c0de111/tinta/hardware/circuit/tinta_l2.pdf

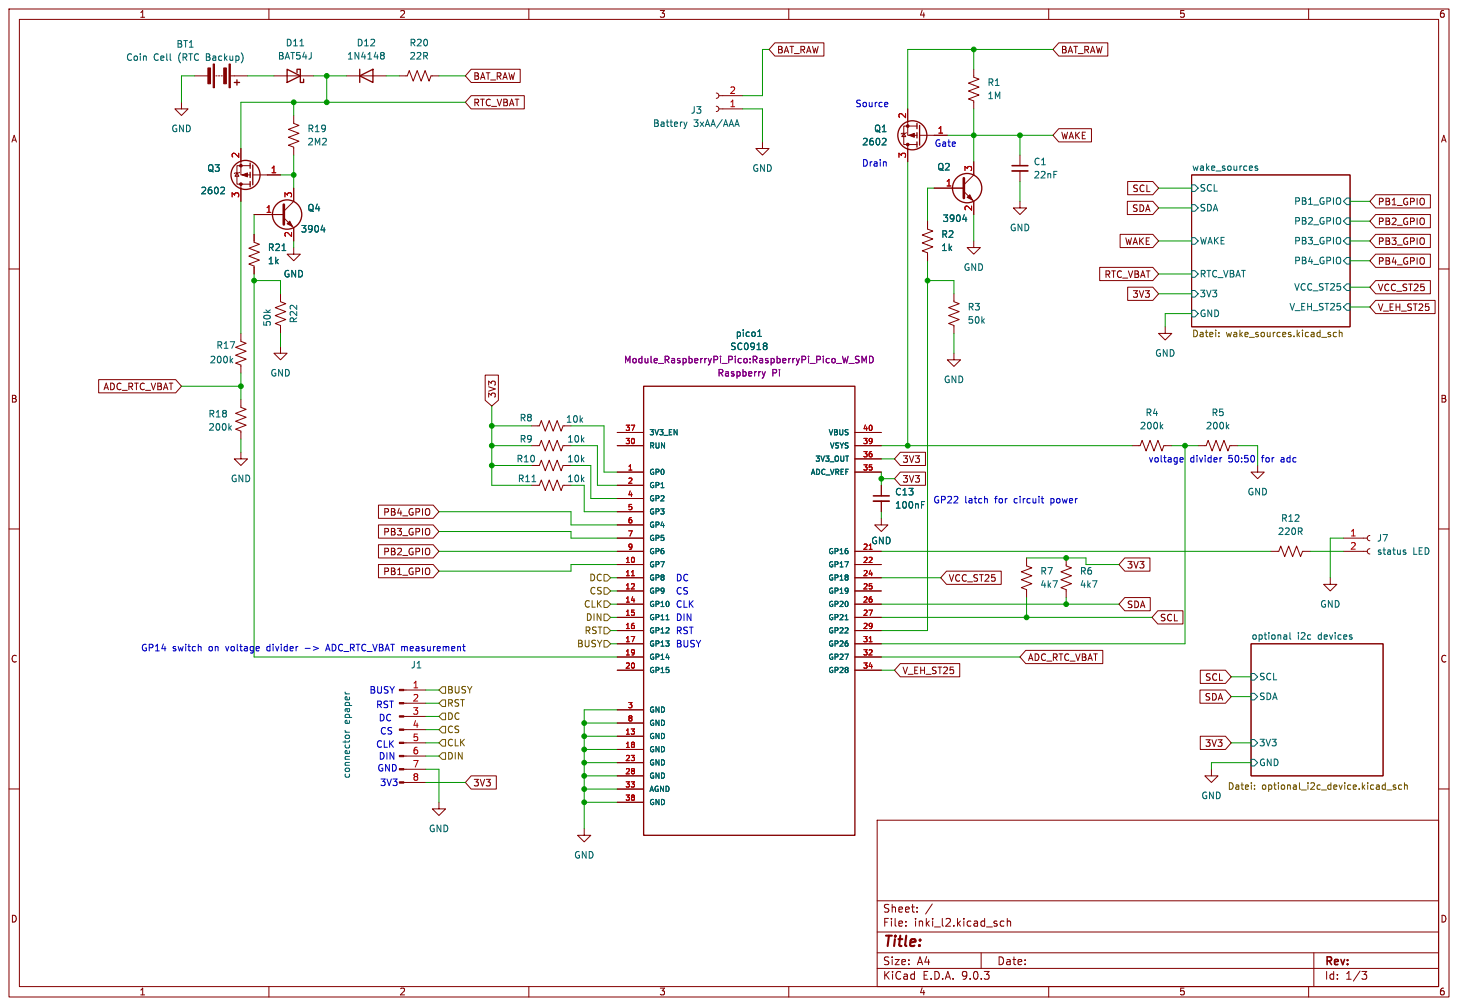
[picture p3: page 1]

BUSY RST CS DC

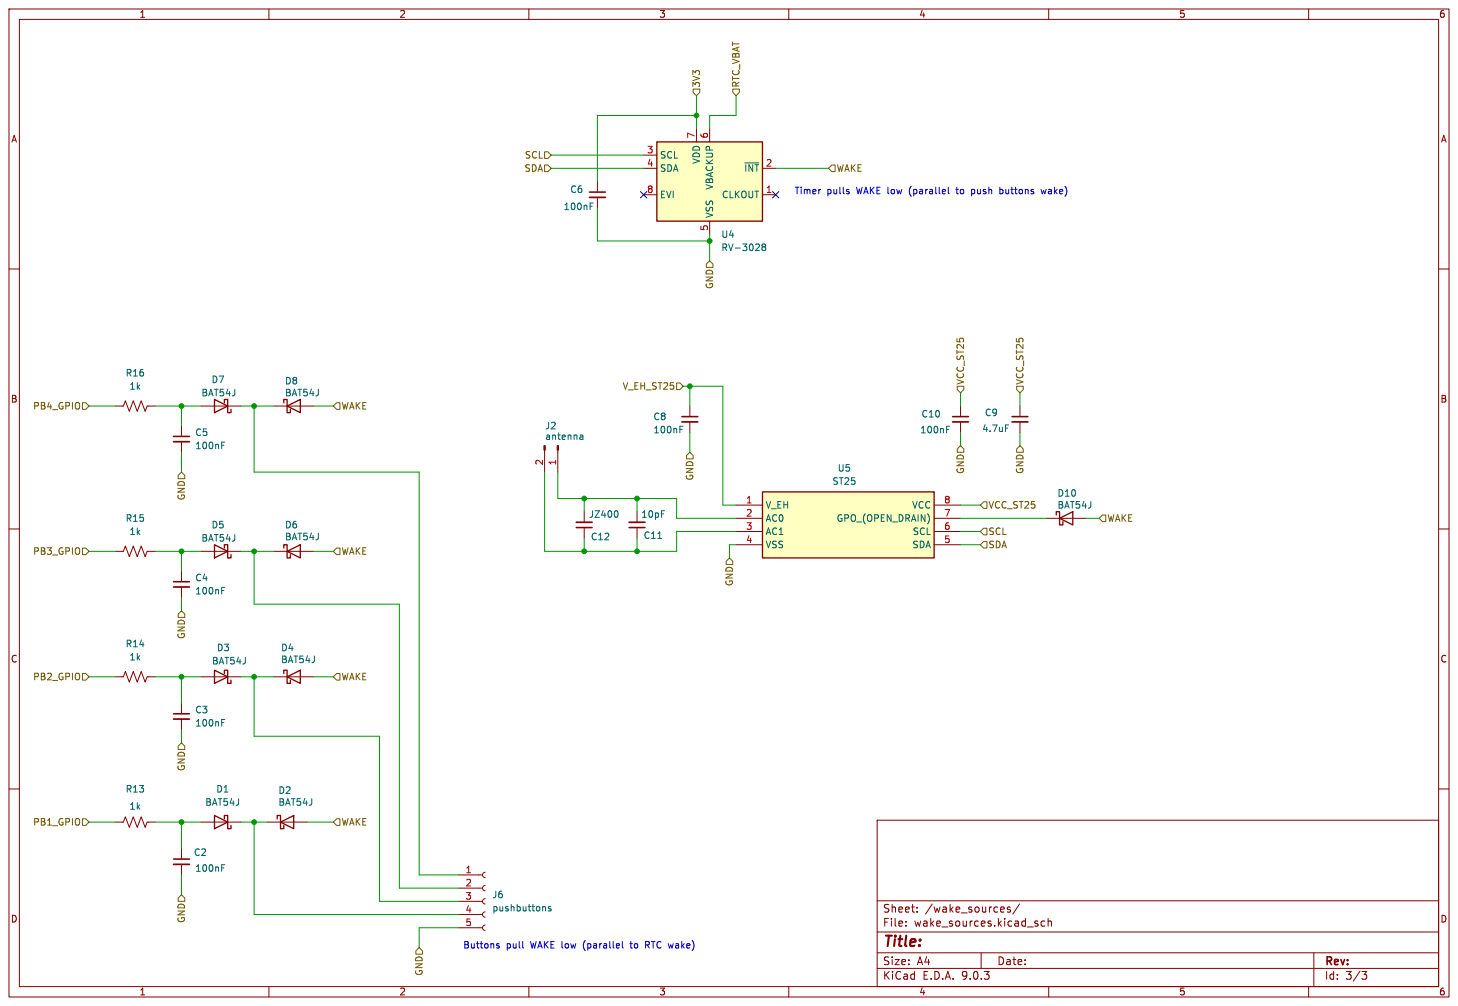
[picture p4: page 2]

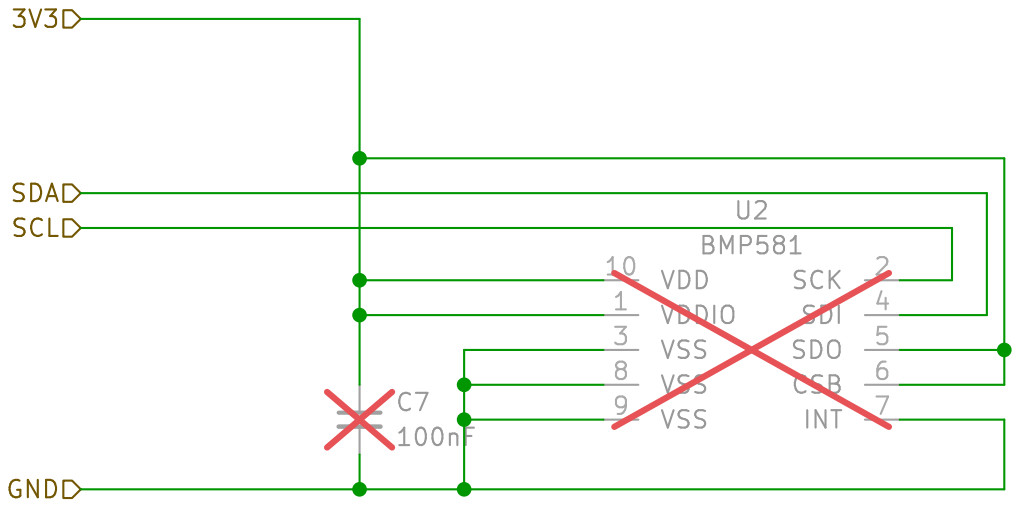
[picture p5: page 3]
