c0de111/tinta/hardware/circuit/tinta_l2.kicad_pcb

## KiCad design hardware/circuit/tinta_l2.kicad_pcb (2026-10-27)

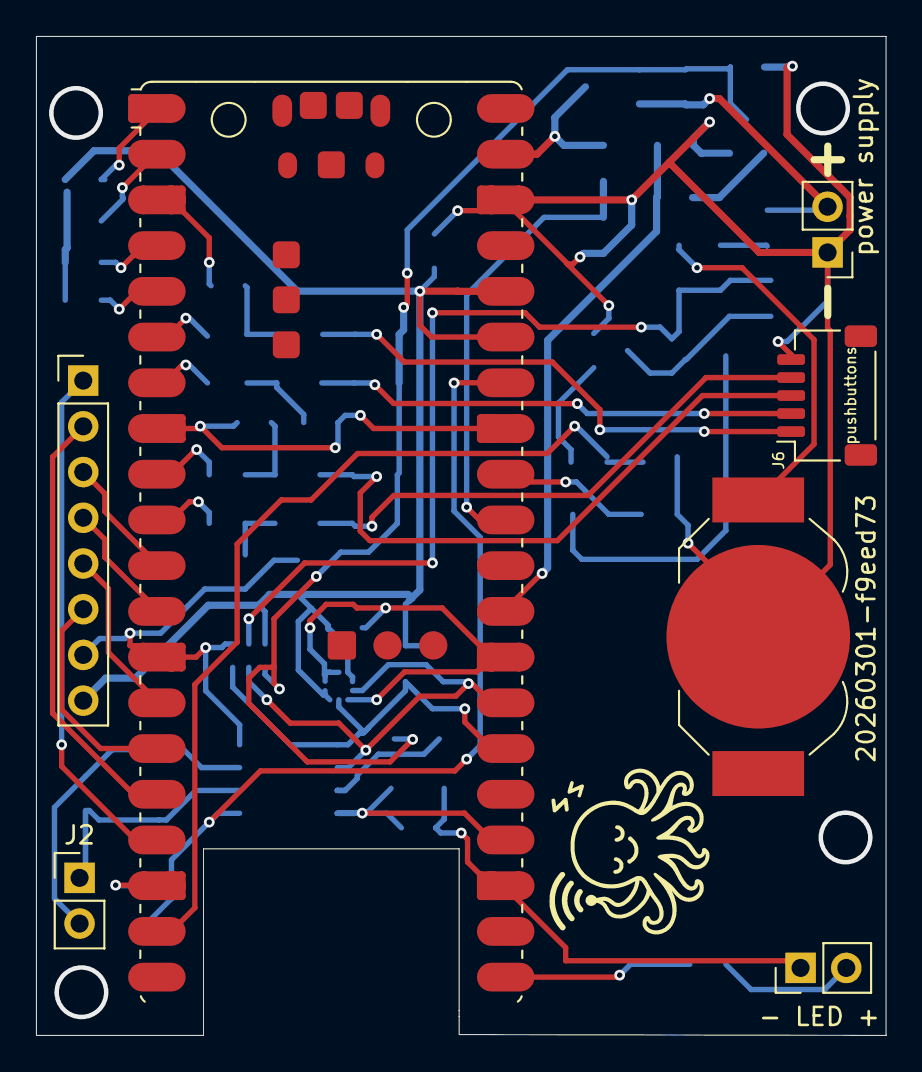
[picture p6: board tinta_l2.kicad_pcb from above]

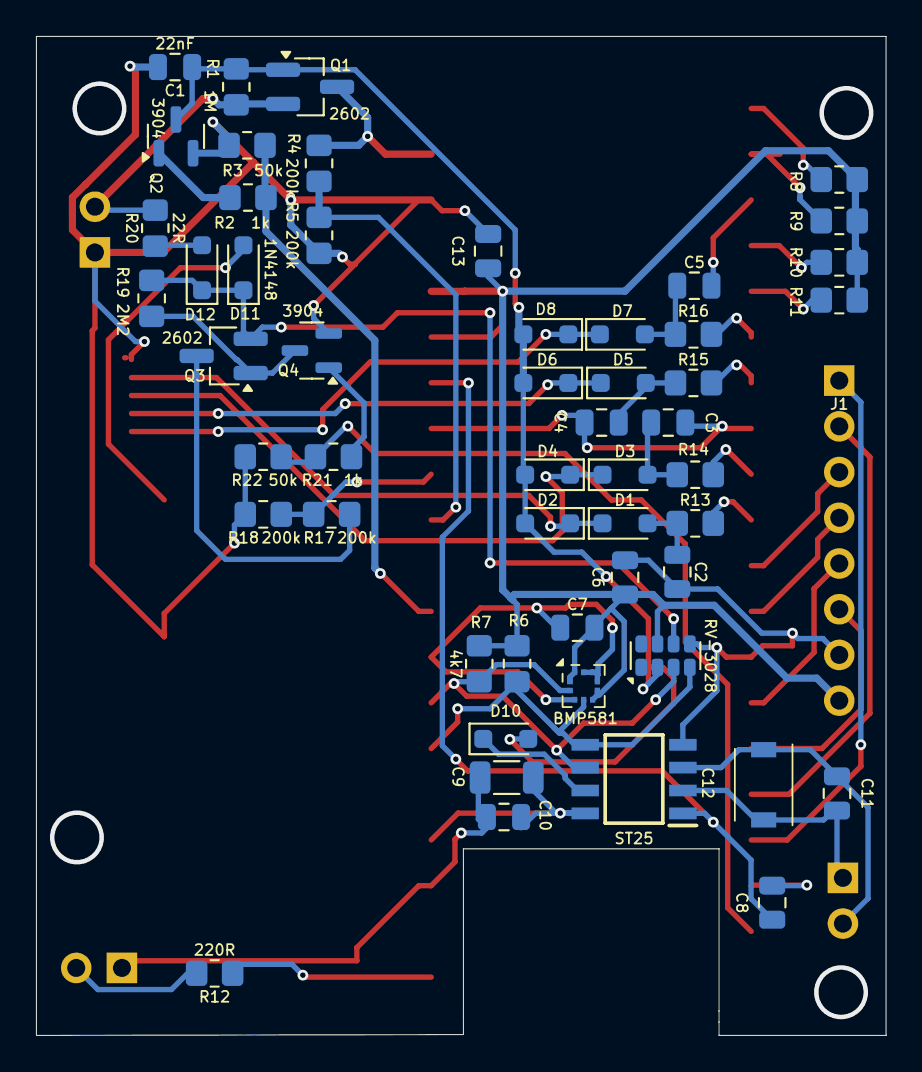
[picture p7: board tinta_l2.kicad_pcb from below]

Board: 2 copper layers, 47.2 x 55.5 mm, 60 parts (53 on the bottom side), 47 nets.

Parts:
BT1: Coin Cell (RTC Backup); BatteryHolder_LINX_BAT-HLD-012-SMT
C1: 22nF; C_0805_2012Metric
C2, C3, C4, C5, C6, C7, C8, C10, C13: 100nF; C_0805_2012Metric
C9: 4.7uF; C_1206_3216Metric
C11: 10pF; C_0805_2012Metric
C12: JZ400
D1, D2, D3, D4, D5, D6, D7, D8, D10, D11: BAT54J; D_SOD-323_HandSoldering
D12: 1N4148; D_SOD-323_HandSoldering
J1: connector epaper; PinHeader_1x08_P2.54mm_Vertical
J2: antenna; PinHeader_1x02_P2.54mm_Vertical
J3: Battery 3xAA/AAA; PinHeader_1x02_P2.54mm_Vertical
J6: pushbuttons; JST_SH_SM05B-SRSS-TB_1x05-1MP_P1.00mm_Horizontal
J7: status LED; PinHeader_1x02_P2.54mm_Vertical
Q1, Q3: 2602; SOT-23_Handsoldering
Q2, Q4: 3904; SOT-23
R1: 1M; R_0805_2012Metric_Pad1.20x1.40mm_HandSolder
R2, R13, R14, R15, R16, R21: 1k; R_0805_2012Metric_Pad1.20x1.40mm_HandSolder
R3, R22: 50k; R_0805_2012Metric_Pad1.20x1.40mm_HandSolder
R4, R5, R17, R18: 200k; R_0805_2012Metric_Pad1.20x1.40mm_HandSolder
R6, R7: 4k7; R_0805_2012Metric_Pad1.20x1.40mm_HandSolder
R8, R9, R10, R11: 10k; R_0805_2012Metric_Pad1.20x1.40mm_HandSolder
R12: 220R; R_0805_2012Metric_Pad1.20x1.40mm_HandSolder
R19: 2M2; R_0805_2012Metric_Pad1.20x1.40mm_HandSolder
R20: 22R; R_0805_2012Metric_Pad1.20x1.40mm_HandSolder
U2: BMP581
U4: RV-3028; MicroCrystal_C7_SON-8_1.5x3.2mm_P0.9mm
U5: ST25; SOIC127P600X175-8N
pico1: SC0918; RaspberryPi_Pico_W_SMD

Connections:
3V3: C6.1, C7.1, C13.1, J1.8, R6.1, R7.1, R8.1, R9.1, R10.1, R11.1, U2.1 (VDDIO), U2.5 (SDO), U2.6 (CSB), U2.10 (VDD), U4.7 (VDD), pico1.35 (ADC_VREF), pico1.36 (3V3_OUT)
/BUSY: J1.1, pico1.17 (GP13)
/CLK: J1.5, pico1.14 (GP10)
/CS: J1.4, pico1.12 (GP9)
/DC: J1.3, pico1.11 (GP8)
/DIN: J1.6, pico1.15 (GP11)
/RST: J1.2, pico1.16 (GP12)
ADC_RTC_VBAT: R17.2, R18.1, pico1.32 (GP27)
BAT_RAW: J3.2, Q1.2 (S), R1.1, R20.2
GND: BT1.2 (-), C1.2, C2.2, C3.2, C4.2, C5.2, C6.2, C7.2, C8.2, C9.2, C10.2, C13.2, J1.7, J3.1, J6.5, J7.1, Q2.2 (E), Q4.2 (E), R3.2, R5.2, R18.2, R22.1, U2.3 (VSS), U2.7 (INT), U2.8 (VSS), U2.9 (VSS), U4.5 (VSS), U5.4 (VSS), pico1.3 (GND), pico1.8 (GND), pico1.13 (GND), pico1.18 (GND), pico1.23 (GND), pico1.28 (GND), pico1.33 (AGND), pico1.38 (GND)
unnamed: BT1.1 (+), D11.2 (A)
unnamed: C2.1, D1.2 (A), R13.1
unnamed: D1.1 (K), D2.1 (K), J6.4
unnamed: C3.1, D3.2 (A), R14.1
unnamed: D3.1 (K), D4.1 (K), J6.3
unnamed: C4.1, D5.2 (A), R15.1
unnamed: D5.1 (K), D6.1 (K), J6.2
unnamed: C5.1, D7.2 (A), R16.1
unnamed: D7.1 (K), D8.1 (K), J6.1
unnamed: D10.1 (K), U5.7 (GPO_(OPEN_DRAIN))
unnamed: D12.2 (A), R20.1
unnamed: C11.2, C12.2, J2.1, U5.2 (AC0)
unnamed: C11.1, C12.1, J2.2, U5.3 (AC1)
unnamed: J7.2, R12.2
unnamed: Q1.3 (D), R4.2, pico1.39 (VSYS)
unnamed: Q2.1 (B), R2.1
unnamed: Q3.3 (D), R17.1
unnamed: Q3.1 (G), Q4.3 (C), R19.2
unnamed: Q4.1 (B), R21.2
unnamed: R8.2, pico1.1 (GP0)
unnamed: R9.2, pico1.2 (GP1)
unnamed: R10.2, pico1.4 (GP2)
unnamed: R11.2, pico1.5 (GP3)
unnamed: R21.1, R22.2, pico1.19 (GP14)
unnamed: R12.1, pico1.21 (GP16)
unnamed: R2.2, R3.1, pico1.29 (GP22)
unnamed: R4.1, R5.1, pico1.31 (GP26)
PB1_GPIO: R13.2, pico1.10 (GP7)
PB2_GPIO: R14.2, pico1.9 (GP6)
PB3_GPIO: R15.2, pico1.7 (GP5)
PB4_GPIO: R16.2, pico1.6 (GP4)
RTC_VBAT: D11.1 (K), D12.1 (K), Q3.2 (S), R19.1, U4.6 (VBACKUP)
SCL: R7.2, U2.2 (SCK), U4.3 (SCL), U5.6 (SCL), pico1.27 (GP21)
SDA: R6.2, U2.4 (SDI), U4.4 (SDA), U5.5 (SDA), pico1.26 (GP20)
VCC_ST25: C9.1, C10.1, U5.8 (VCC), pico1.24 (GP18)
V_EH_ST25: C8.1, U5.1 (V_EH), pico1.34 (GP28)
WAKE: C1.1, D2.2 (A), D4.2 (A), D6.2 (A), D8.2 (A), D10.2 (A), Q1.1 (G), Q2.3 (C), R1.2, U4.2 (~INT)
